sui77/PrinterPiano/pictures/printed.jpg

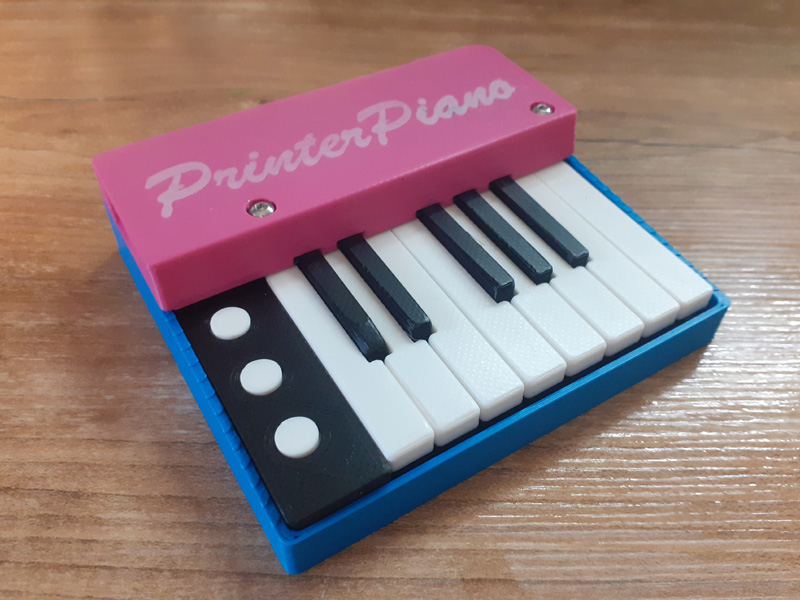
pictures/printed.jpg
