sui77/PrinterPiano/pictures/pcb.jpg

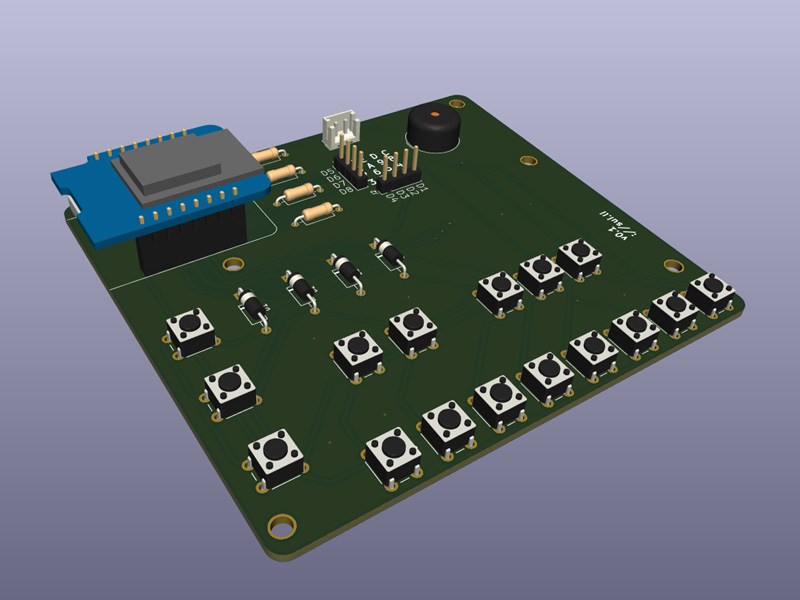
pictures/pcb.jpg
