sui77/PrinterPiano/README.md

# PrinterPiano
This tiny keyboard will turn your 3d printer itself into a music instrument. 

@see https://www.printables.com/model/444297
