sui77/PrinterPiano/pictures/blender.jpg

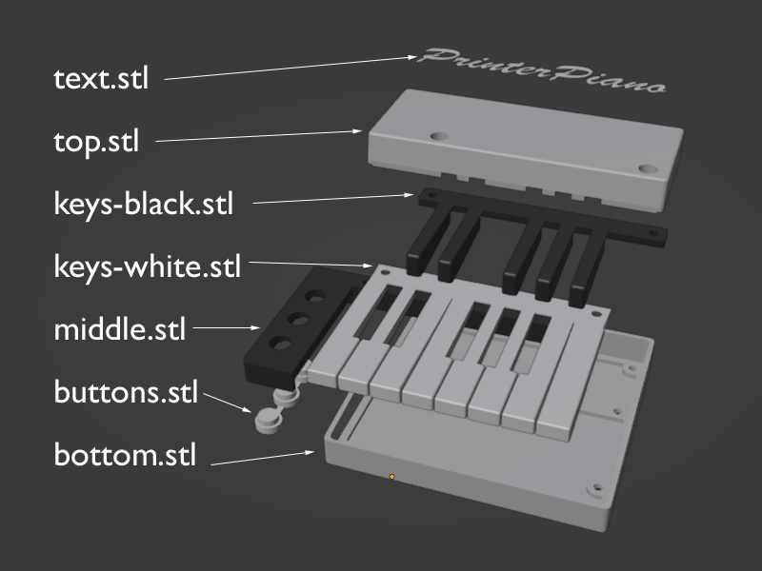
pictures/blender.jpg
