sui77/PrinterPiano/pictures/pcb_board.jpg

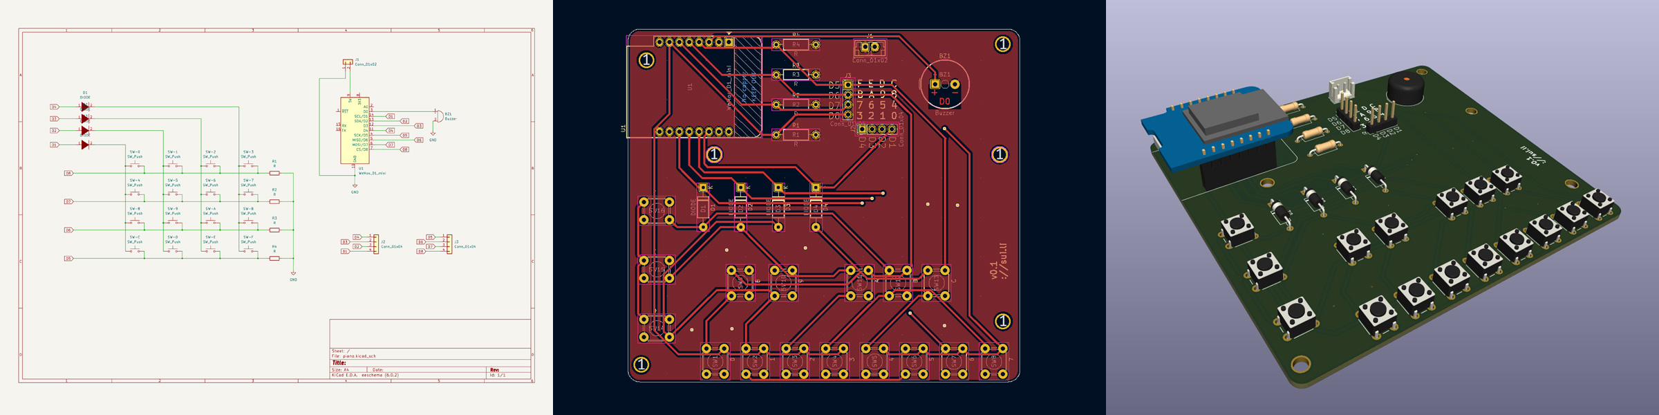
pictures/pcb_board.jpg
