sui77/PrinterPiano/pictures/pcb_prototype.jpg

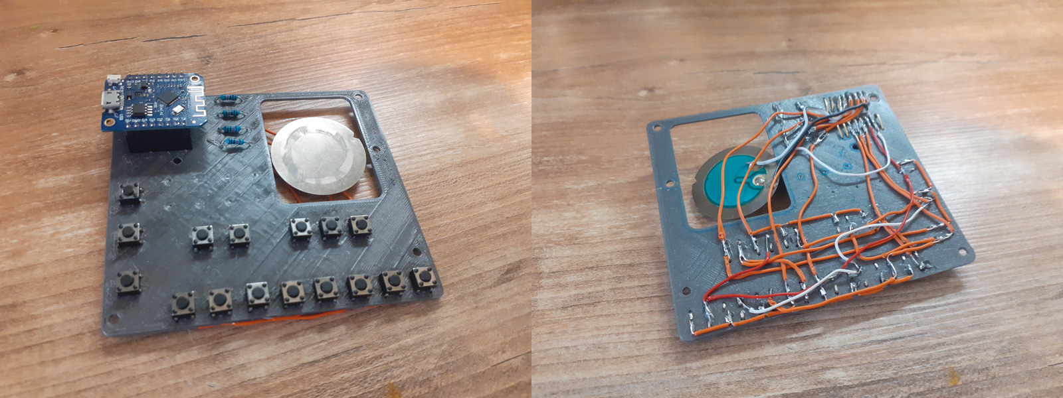
pictures/pcb_prototype.jpg
