sui77/PrinterPiano/pictures/rendered.jpg

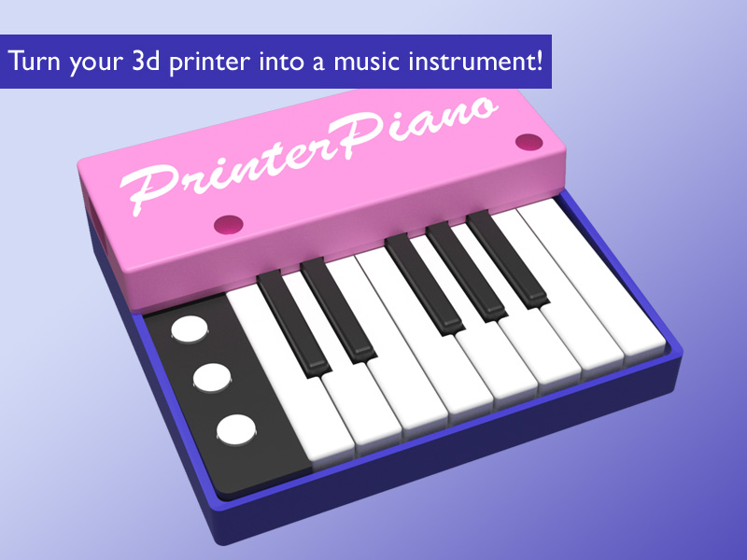
pictures/rendered.jpg
