sui77/PrinterPiano/Case-3d-Model/stl/middle.stl

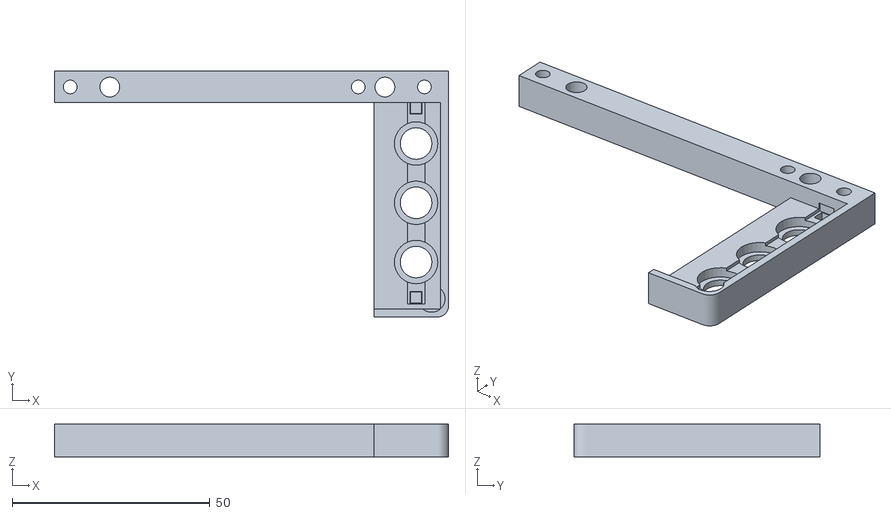
[picture p7: CAD file, 2023-05-05]
Case-3d-Model/stl/middle.stl
99.7 x 62.2 x 8.35
