sui77/PrinterPiano/Case-3d-Model/stl/top.stl

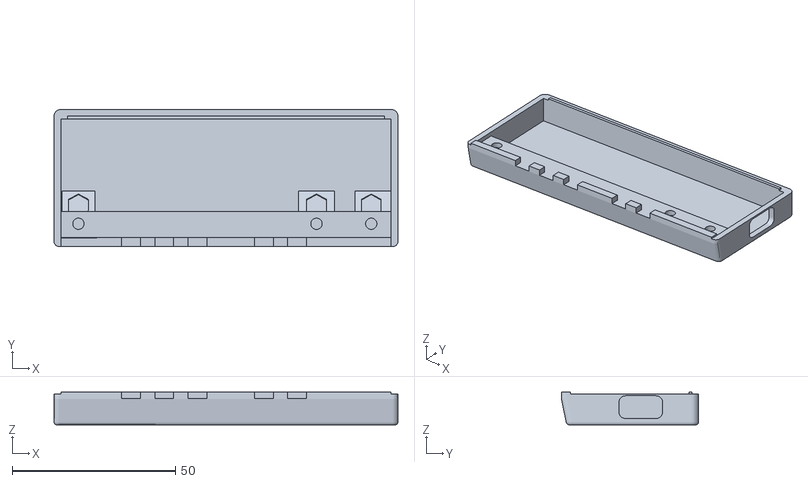
[picture p8: CAD file, 2023-05-05]
Case-3d-Model/stl/top.stl
105.3 x 42.0 x 10.1
