sui77/PrinterPiano/Case-3d-Model/stl/bottom.stl

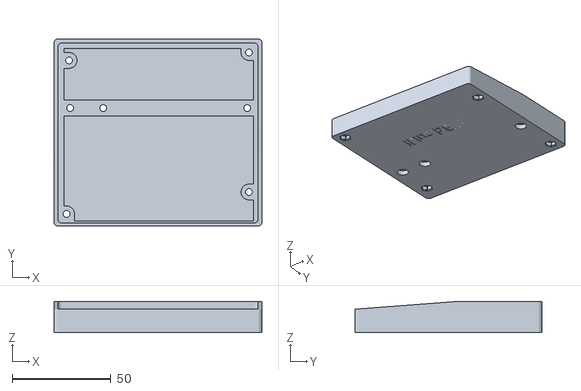
[picture p9: CAD file, 2023-05-05]
Case-3d-Model/stl/bottom.stl
105.3 x 94.8 x 15.9
