sui77/PrinterPiano/Case-3d-Model/stl/keys-black.stl

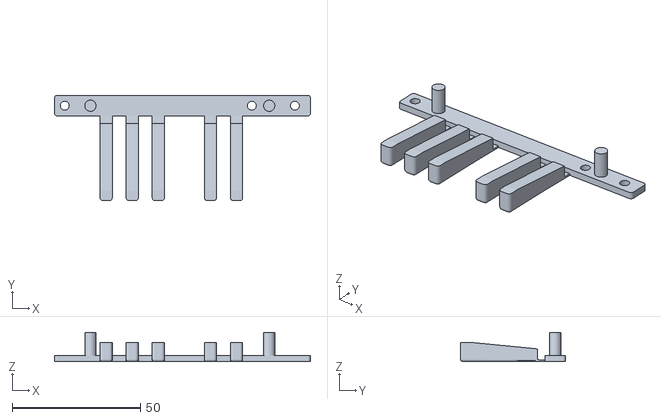
[picture p10: CAD file, 2023-05-05]
Case-3d-Model/stl/keys-black.stl
99.7 x 41.0 x 11.4
