sui77/PrinterPiano/Case-3d-Model/stl/decoration_Music.stl

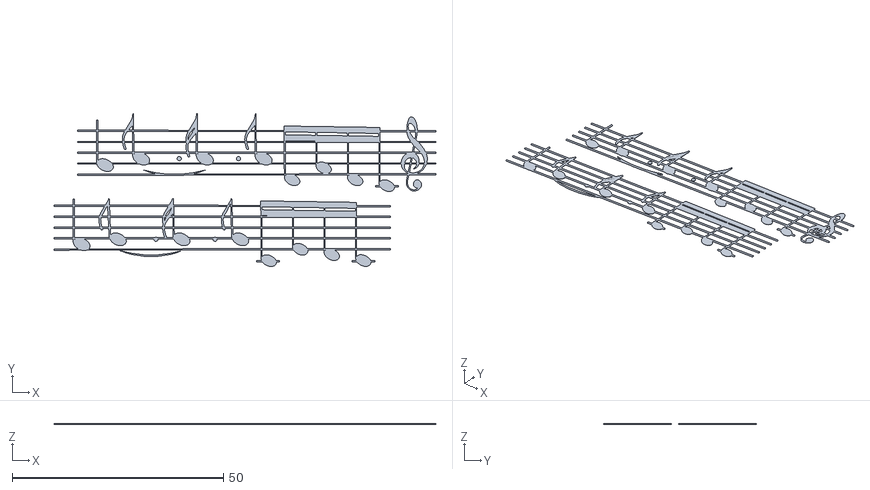
[picture p11: CAD file, 2023-05-05]
Case-3d-Model/stl/decoration_Music.stl
90.4 x 36.3 x 0.26
