sui77/PrinterPiano/Case-3d-Model/stl/keys-white.stl

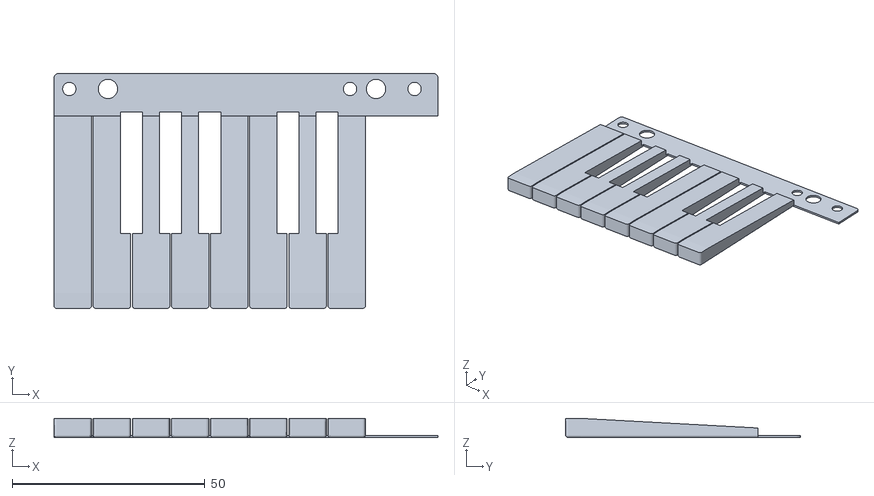
[picture p12: CAD file, 2023-05-05]
Case-3d-Model/stl/keys-white.stl
99.7 x 61.0 x 5.00
