sui77/PrinterPiano/Case-3d-Model/stl/buttons.stl

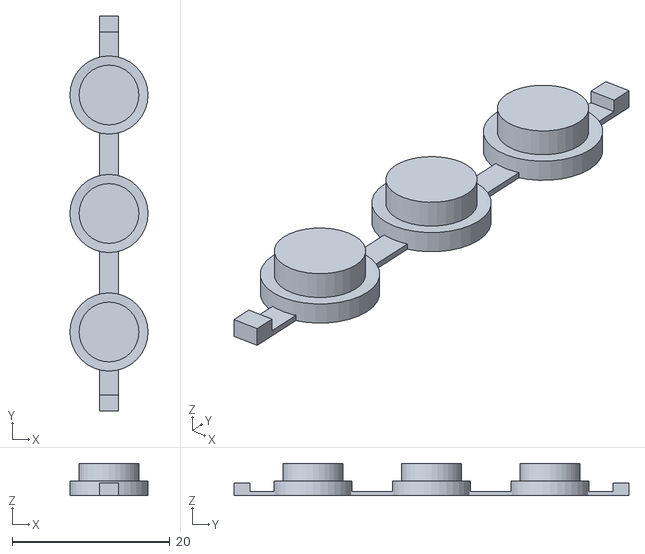
[picture p13: CAD file, 2023-05-05]
Case-3d-Model/stl/buttons.stl
9.90 x 50.0 x 4.05
