sui77/PrinterPiano/Case-3d-Model/stl/pcb_mockup.stl

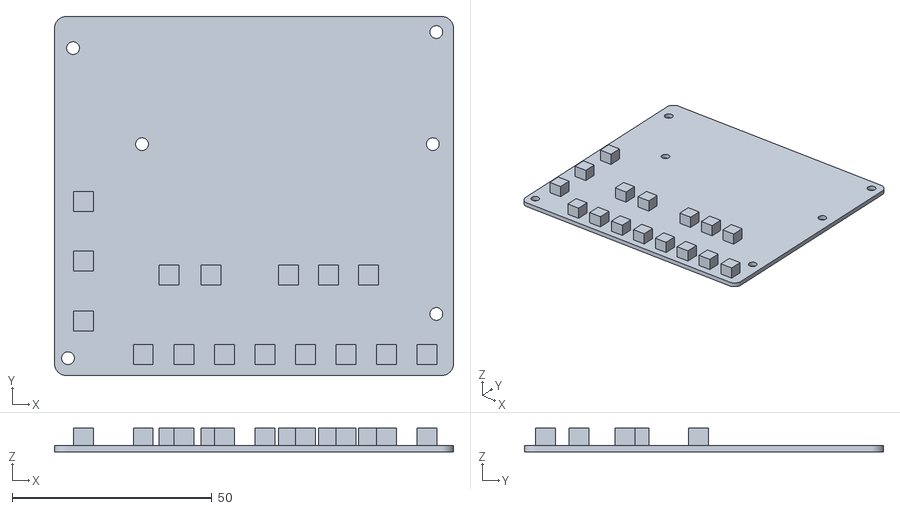
[picture p14: CAD file, 2023-04-07]
Case-3d-Model/stl/pcb_mockup.stl
100.0 x 90.0 x 5.90
