sui77/PrinterPiano/Case-3d-Model/stl/decoration_PrinterPiano.stl

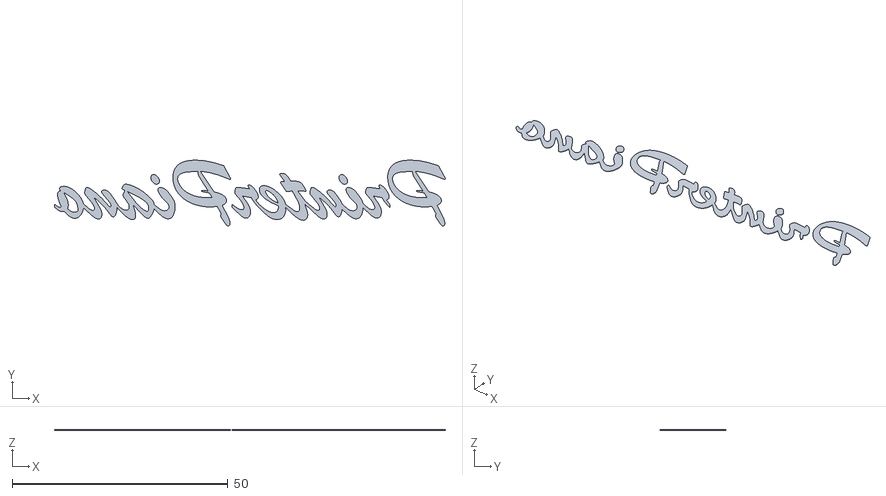
[picture p15: CAD file, 2023-04-07]
Case-3d-Model/stl/decoration_PrinterPiano.stl
90.7 x 15.3 x 0.25
