sui77/PrinterPiano/Case-3d-Model/stl/pcb_prototype.stl

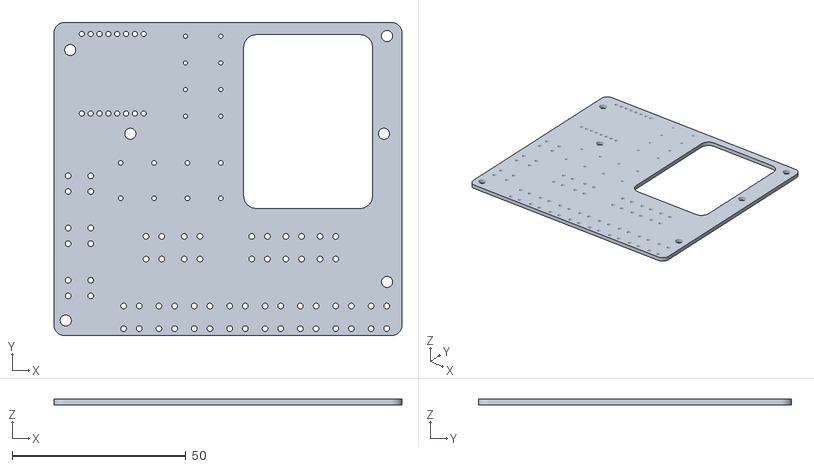
[picture p16: CAD file, 2023-04-07]
Case-3d-Model/stl/pcb_prototype.stl
100.0 x 90.0 x 1.60
