sui77/PrinterPiano/PCB/piano.kicad_pcb

## KiCad design PCB/piano.kicad_pcb (2023-05-05)

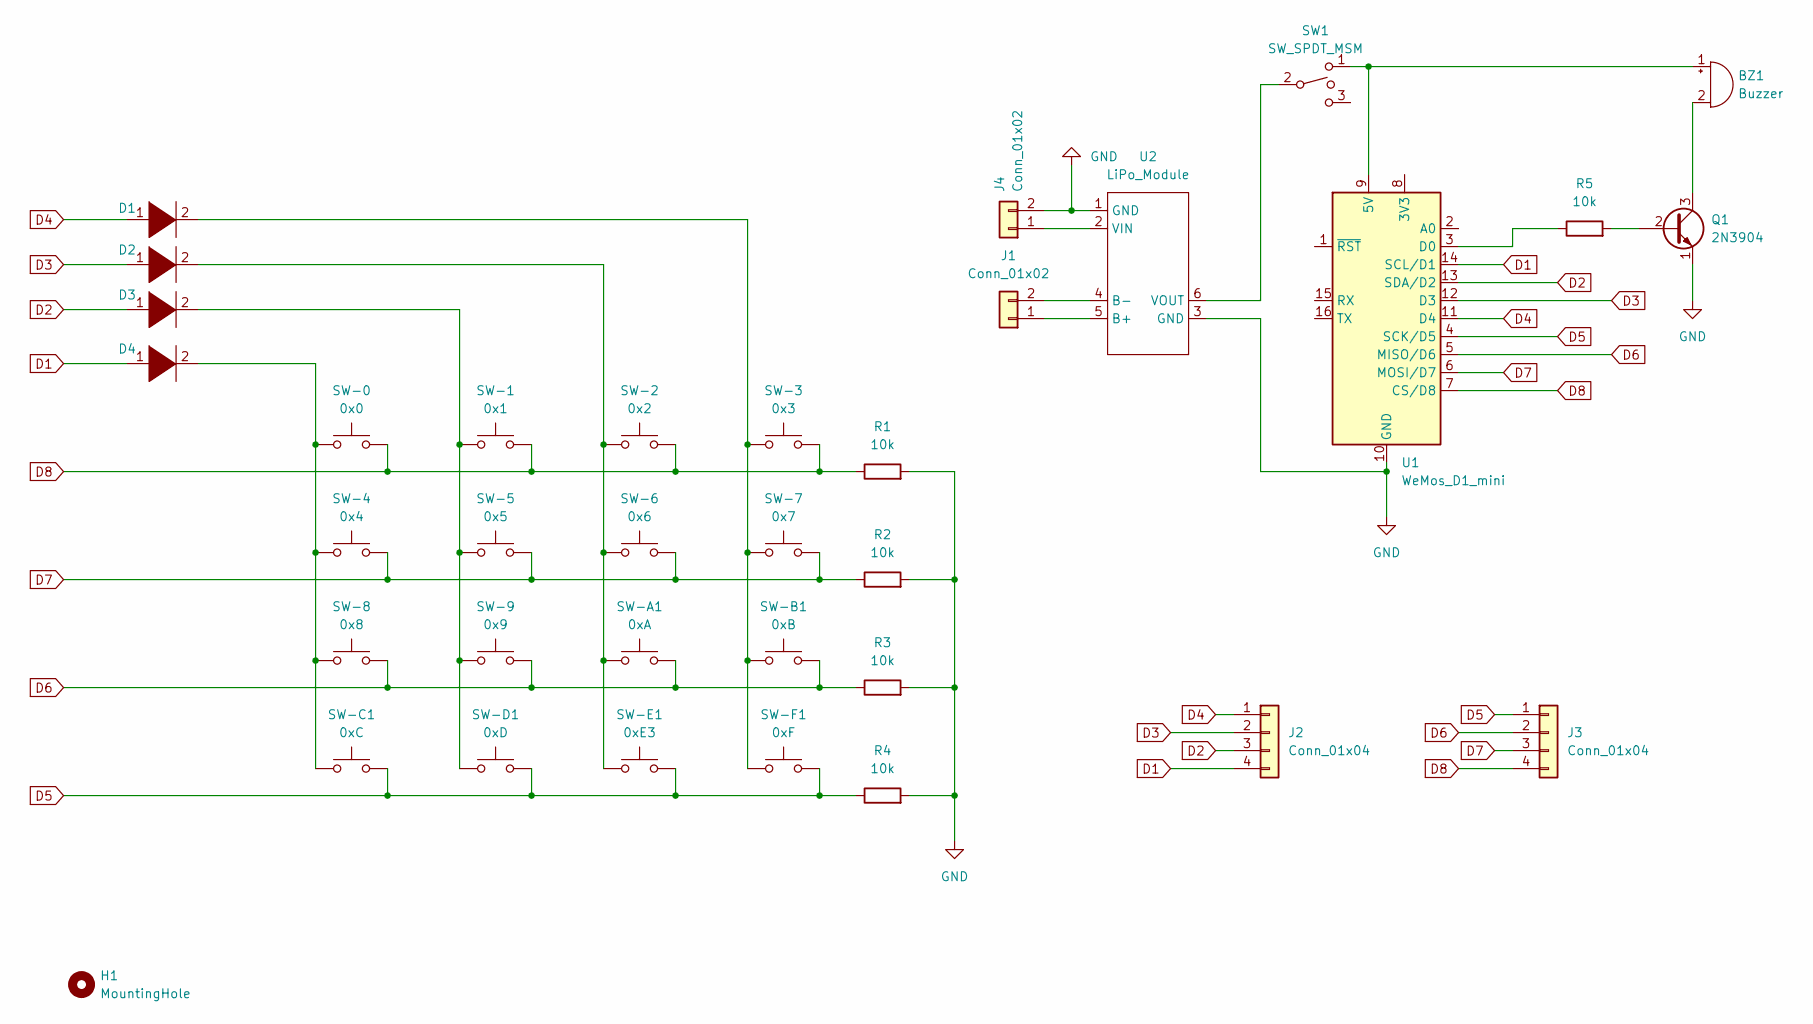
[picture p17: schematic piano.kicad_sch]

Parts:
BZ1: Buzzer; Buzzer_12x9.5RM7.6
D1, D2, D3, D4: DIODE; D_0805_2012Metric
H1: MountingHole
J1, J4: Conn_01x02; JST_EH_B2B-EH-A_1x02_P2.50mm_Vertical
J2, J3: Conn_01x04; PinHeader_1x04_P2.54mm_Vertical
Q1: 2N3904; TO-92_Inline
R1, R2, R3, R4, R5: 10k; R_1206_3216Metric_Pad1.30x1.75mm_HandSolder
SW1: SW_SPDT_MSM; Schiebeschalter
SW-0: 0x0; SW_PUSH_6mm
SW-1: 0x1; SW_PUSH_6mm
SW-2: 0x2; SW_PUSH_6mm
SW-3: 0x3; SW_PUSH_6mm
SW-4: 0x4; SW_PUSH_6mm
SW-5: 0x5; SW_PUSH_6mm
SW-6: 0x6; SW_PUSH_6mm
SW-7: 0x7; SW_PUSH_6mm
SW-8: 0x8; SW_PUSH_6mm
SW-9: 0x9; SW_PUSH_6mm
SW-A1: 0xA; SW_PUSH_6mm
SW-B1: 0xB; SW_PUSH_6mm
SW-C1: 0xC; SW_PUSH_6mm
SW-D1: 0xD; SW_PUSH_6mm
SW-E1: 0xE3; SW_PUSH_6mm
SW-F1: 0xF; SW_PUSH_6mm
U1: WeMos_D1_mini; WEMOS_D1_mini_light
U2: LiPo_Module; LiPoChargerModule

Connections:
D1: D4.1 (K), J2.4, U1.14 (SCL/D1)
D2: D3.1 (K), J2.3, U1.13 (SDA/D2)
D3: D2.1 (K), J2.2, U1.12 (D3)
D4: D1.1 (K), J2.1, U1.11 (D4)
D5: J3.1, R4.1, SW-C1.2, SW-D1.2, SW-E1.2, SW-F1.2, U1.4 (SCK/D5)
D6: J3.2, R3.1, SW-8.2, SW-9.2, SW-A1.2, SW-B1.2, U1.5 (MISO/D6)
D7: J3.3, R2.1, SW-4.2, SW-5.2, SW-6.2, SW-7.2, U1.6 (MOSI/D7)
D8: J3.4, R1.1, SW-0.2, SW-1.2, SW-2.2, SW-3.2, U1.7 (CS/D8)
GND: J4.2, Q1.1 (E), R1.2, R2.2, R3.2, R4.2, U1.10 (GND), U2.1 (GND), U2.3 (GND)
unnamed: BZ1.2 (+), Q1.3 (C)
unnamed: D1.2 (A), SW-3.1, SW-7.1, SW-B1.1, SW-F1.1
unnamed: D2.2 (A), SW-2.1, SW-6.1, SW-A1.1, SW-E1.1
unnamed: D3.2 (A), SW-1.1, SW-5.1, SW-9.1, SW-D1.1
unnamed: D4.2 (A), SW-0.1, SW-4.1, SW-8.1, SW-C1.1
unnamed: J1.1, U2.5 (B+)
unnamed: J1.2, U2.4 (B-)
unnamed: J4.1, U2.2 (VIN)
unnamed: Q1.2 (B), R5.2
unnamed: BZ1.1 (-), SW1.1, U1.9 (5V)
unnamed: SW1.2, U2.6 (VOUT)
unnamed: R5.1, U1.3 (D0)

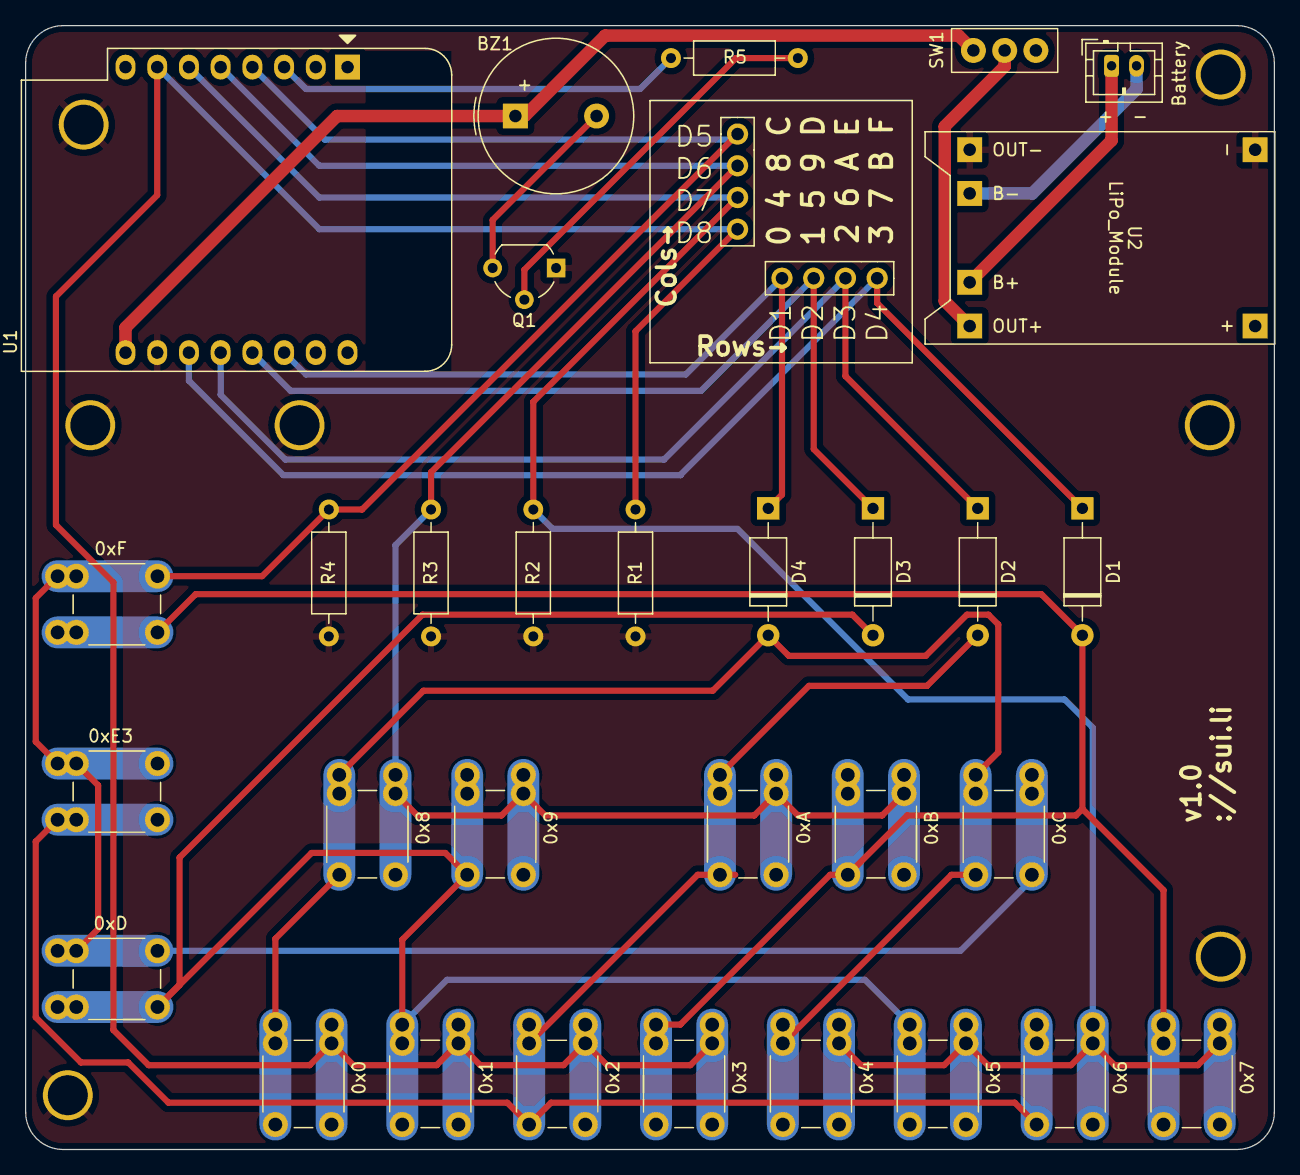
[picture p18: board piano.kicad_pcb from above]

Board: 2 copper layers, 100.0 x 90.0 mm, 33 parts (0 on the bottom side), 20 nets.
