sui77/PrinterPiano/(commit log)

2023-04-07 initial load
    [bottom.stl, buttons.stl, keys-black.stl, keys-white.stl, middle.stl, pcb_mockup.stl, pcb_prototype.stl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]
2023-04-25 v0.2 PCB
    [piano-B_Cu.gbr, piano-B_Mask.gbr, piano-B_Paste.gbr, piano-B_Silkscreen.gbr, piano-Edge_Cuts.gbr, piano-F_Cu.gbr, piano-F_Mask.gbr, piano-F_Paste.gbr]
2023-05-05 update pcb (larger footprint for transistor)
    [piano-B_Cu.gbr, piano-B_Mask.gbr, piano-B_Paste.gbr, piano-B_Silkscreen.gbr, piano-Edge_Cuts.gbr, piano-F_Cu.gbr, piano-F_Mask.gbr, piano-F_Paste.gbr]
2023-05-05 update case model
    [bottom.stl, buttons.stl, decoration_Music.stl, decoration_PrinterPiano.stl, keys-black.stl, keys-white.stl, middle.stl, text.stl]
